chiefwithbeef44/Lobotomizer/1590DD.jpg

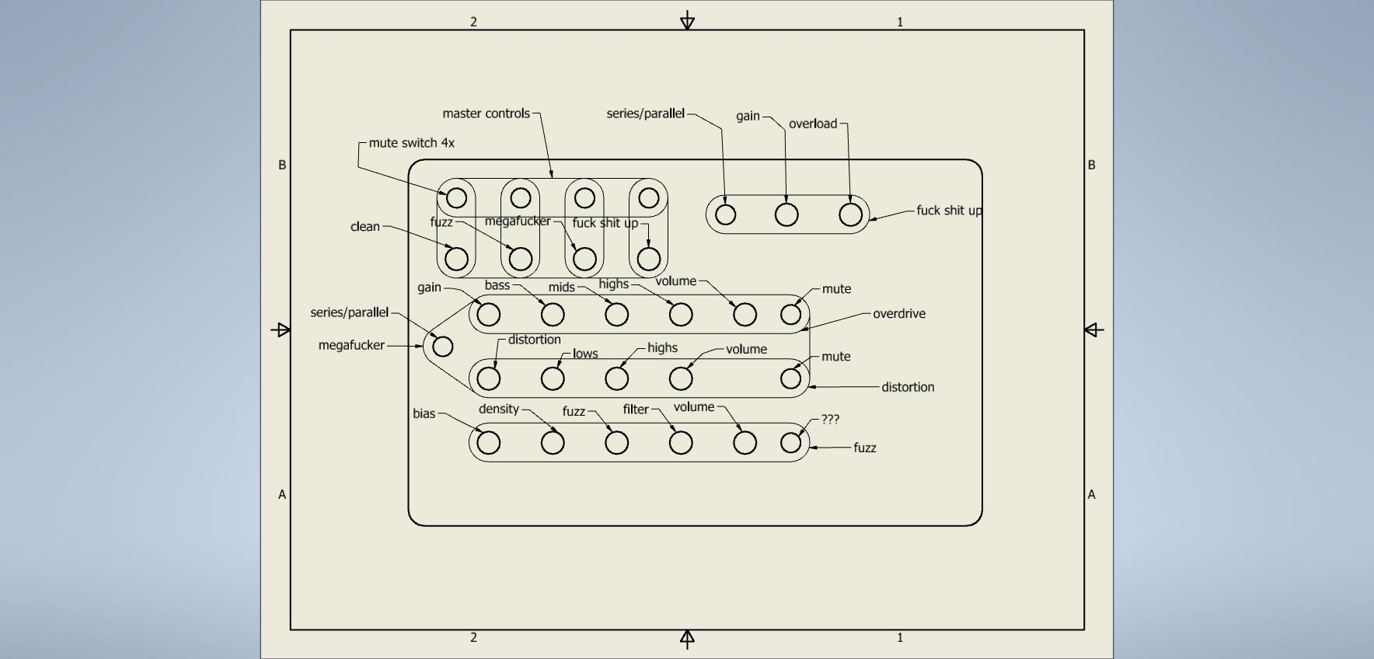
1590DD.jpg
