chiefwithbeef44/Lobotomizer/BSilk/hammer.png

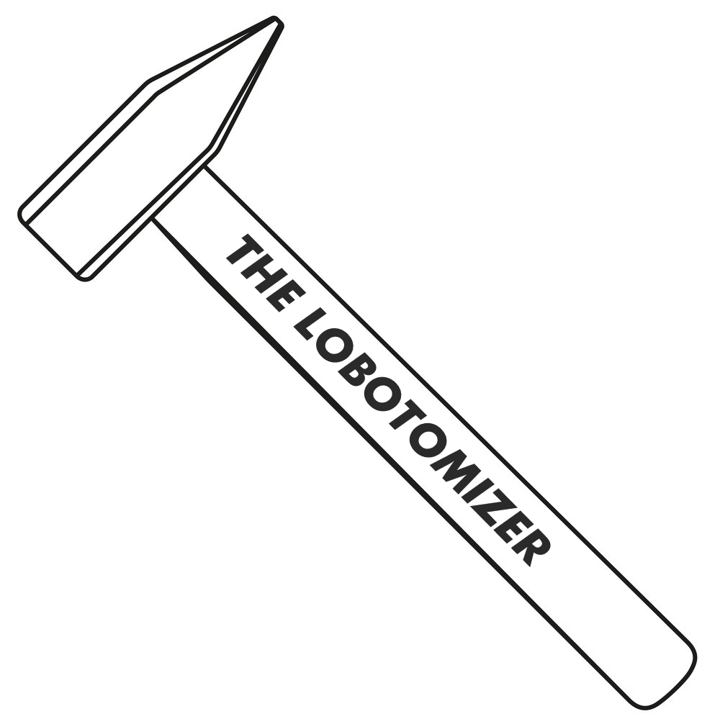
BSilk/hammer.png
