chiefwithbeef44/Lobotomizer/BSilk/lobotomizer.png

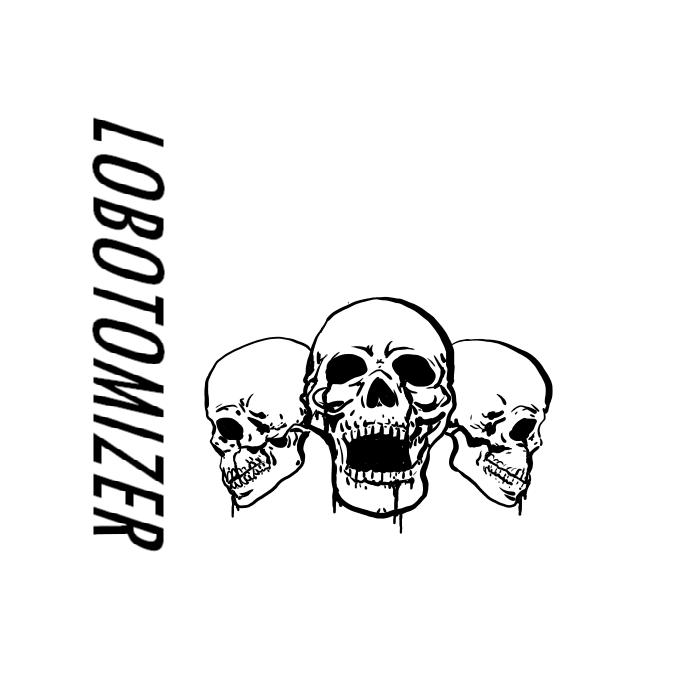
BSilk/lobotomizer.png
