chiefwithbeef44/Lobotomizer/BOM.xlsx

# | QUANTITY | PART NUMBER | MANUFACTURER PART NUMBER | DESCRIPTION | CUSTOMER REFERENCE | BACKORDER | UNIT PRICE | EXTENDED PRICE
1 | 3 | BC5223CT-ND | K101J10C0GF5UH5 | CAP CER 100PF 50V C0G/NP0 RADIAL |  | 0 | 0.19 | 0.57
2 | 11 | 399-9859-1-ND | C315C104M5U5TA7303 | CAP CER 0.1UF 50V Z5U RADIAL |  | 0 | 0.157 | 1.73
3 | 7 | 732-8851-1-ND | 860020672005 | CAP ALUM 1UF 20% 50V RADIAL |  | 0 | 0.1 | 0.70
4 | 2 | BC2677CT-ND | K223K10X7RF5UH5 | CAP CER 0.022UF 50V X7R RADIAL |  | 0 | 0.23 | 0.46
5 | 1 | BC5112-ND | D102K20Y5PH63L2R | CAP CER 1000PF 100V Y5P RADIAL |  | 0 | 0.2 | 0.20
6 | 1 | 399-13958-ND | C315C300J1G5TA | CAP CER 30PF 5% 100V C0G RADIAL |  | 0 | 0.42 | 0.42
7 | 1 | 399-9725-ND | C315C229D2G5TA | CAP CER 2.2PF 200V NP0 RADIAL |  | 0 | 0.58 | 0.58
8 | 3 | 732-8854-1-ND | 860020672008 | CAP ALUM 4.7UF 20% 50V RADIAL |  | 0 | 0.11 | 0.33
9 | 1 | BC2683CT-ND | K472K10X7RF5UH5 | CAP CER 4700PF 50V X7R RADIAL |  | 0 | 0.21 | 0.21
10 | 3 | 732-8654-1-ND | 860010672002 | CAP ALUM 0.22UF 20% 50V RADIAL |  | 0 | 0.1 | 0.30
11 | 2 | 732-8656-1-ND | 860010672004 | CAP ALUM 0.47UF 20% 50V RADIAL |  | 0 | 0.11 | 0.22
12 | 1 | BC2691CT-ND | K682K10X7RH5UH5 | CAP CER 6800PF 100V X7R RADIAL |  | 0 | 0.26 | 0.26
13 | 1 | BC2672CT-ND | K221K10X7RF5UH5 | CAP CER 220PF 50V X7R RADIAL |  | 0 | 0.19 | 0.19
14 | 6 | 1N4148VSCT-ND | 1N4148TR | DIODE GEN PURP 75V 300MA DO35 |  | 0 | 0.1 | 0.60
15 | 2 | 1N5817DICT-ND | 1N5817-T | DIODE SCHOTTKY 20V 1A DO41 |  | 0 | 0.39 | 0.78
16 | 2 | 1N4001GP-E3/54GICT-ND | 1N4001GP-E3/54 | DIODE GEN PURP 50V 1A DO204AL |  | 0 | 0.57 | 1.14
17 | 4 | 1N5227BTRFSCT-ND | 1N5227BTR | DIODE ZENER 3.6V 500MW DO35 |  | 0 | 0.16 | 0.64
18 | 2 | 1514-2N5089PBFREE-ND | 2N5089 PBFREE | TRANS NPN 25V 0.05A TO-92 |  | 0 | 0.49 | 0.98
19 | 2 | 2368-NTE467-ND | NTE467 | JFET-N-CH CHOPPER/FAST SW |  | 0 | 1.31 | 2.62
20 | 1 | 1514-2N5087PBFREE-ND | 2N5087 PBFREE | TRANS PNP 50V 0.05A TO-92 |  | 0 | 0.49 | 0.49
21 | 2 | MPSA05-APMSCT-ND | MPSA05-AP | TRANS NPN 60V 0.625A TO-92 |  | 0 | 0.34 | 0.68
22 | 3 | CF14JT470KCT-ND | CF14JT470K | RES 470K OHM 5% 1/4W AXIAL |  | 0 | 0.1 | 0.30
23 | 3 | CF14JT47K0CT-ND | CF14JT47K0 | RES 47K OHM 5% 1/4W AXIAL |  | 0 | 0.1 | 0.30
24 | 1 | CF14JT22K0CT-ND | CF14JT22K0 | RES 22K OHM 5% 1/4W AXIAL |  | 0 | 0.1 | 0.10
25 | 1 | CF14JT2K20CT-ND | CF14JT2K20 | RES 2.2K OHM 5% 1/4W AXIAL |  | 0 | 0.1 | 0.10
26 | 1 | CF14JT47R0CT-ND | CF14JT47R0 | RES 47 OHM 5% 1/4W AXIAL |  | 0 | 0.1 | 0.10
27 | 1 | CF14JT560RCT-ND | CF14JT560R | RES 560 OHM 5% 1/4W AXIAL |  | 0 | 0.1 | 0.10
28 | 1 | CF14JT1K50CT-ND | CF14JT1K50 | RES 1.5K OHM 5% 1/4W AXIAL |  | 0 | 0.1 | 0.10
29 | 1 | S470QCT-ND | CFM14JT470R | RES 470 OHM 5% 1/4W AXIAL |  | 0 | 0.1 | 0.10
30 | 10 | CF12JT100KCT-ND | CF12JT100K | RES 100K OHM 5% 1/2W AXIAL |  | 0 | 0.065 | 0.65
31 | 10 | CF12JT100KCT-ND | CF12JT100K | RES 100K OHM 5% 1/2W AXIAL |  | 0 | 0.065 | 0.65
32 | 12 | CF14JT1M00CT-ND | CF14JT1M00 | RES 1M OHM 5% 1/4W AXIAL |  | 0 | 0.036 | 0.43
33 | 12 | CF14JT10K0CT-ND | CF14JT10K0 | RES 10K OHM 5% 1/4W AXIAL |  | 0 | 0.036 | 0.43
34 | 10 | CF14JT1K00CT-ND | CF14JT1K00 | RES 1K OHM 5% 1/4W AXIAL |  | 0 | 0.036 | 0.36
35 | 2 | CF14JT39K0CT-ND | CF14JT39K0 | RES 39K OHM 5% 1/4W AXIAL |  | 0 | 0.1 | 0.20
36 | 2 | BC4514CT-ND | MBB0207VD5001BC100 | RES 5K OHM 0.1% 0.4W AXIAL |  | 0 | 0.66 | 1.32
37 | 1 | CF14JT6K80CT-ND | CF14JT6K80 | RES 6.8K OHM 5% 1/4W AXIAL |  | 0 | 0.1 | 0.10
38 | 1 | CF14JT68K0CT-ND | CF14JT68K0 | RES 68K OHM 5% 1/4W AXIAL |  | 0 | 0.1 | 0.10
39 | 1 | CF14JT910KCT-ND | CF14JT910K | RES 910K OHM 5% 1/4W AXIAL |  | 0 | 0.1 | 0.10
40 | 2 | CF14JT180KCT-ND | CF14JT180K | RES 180K OHM 5% 1/4W AXIAL |  | 0 | 0.1 | 0.20
41 | 1 | CF14JT4K70CT-ND | CF14JT4K70 | RES 4.7K OHM 5% 1/4W AXIAL |  | 0 | 0.1 | 0.10
42 | 1 | CF14JT220RCT-ND | CF14JT220R | RES 220 OHM 5% 1/4W AXIAL |  | 0 | 0.1 | 0.10
43 | 1 | 987-1305-ND | P160KN-0QC15B50K | POT 50K OHM 1/5W PLASTIC LINEAR |  | 0 | 0.85 | 0.85
44 | 3 | 987-1667-ND | P160KN-0QD15B1MEG | POT 1M OHM 1/5W PLASTIC LINEAR |  | 0 | 0.85 | 2.55
45 | 8 | 987-1300-ND | P160KN-0QC15B100K | POT 100K OHM 1/5W PLASTIC LINEAR |  | 0 | 0.85 | 6.80
46 | 5 | 2368-54-302PC-ND | 54-302PC | SW-TOGGLE SPDT 5A |  | 0 | 1.42 | 7.10
47 | 1 | 2368-54-303E-ND | 54-303E | SWITCH/TOGGLE/SPDT/5A |  | 0 | 1.97 | 1.97
48 | 1 | 2368-54-307PC-ND | 54-307PC | SW TOGGLE DPDT 5A |  | 0 | 1.66 | 1.66
49 | 1 | 296-7414-5-ND | TLC27M4AIN | IC OPAMP GP 4 CIRCUIT 14DIP |  | 0 | 1.72 | 1.72
50 | 1 | 497-2947-5-ND | L7805ABV | IC REG LINEAR 5V 1.5A TO220AB |  | 0 | 0.7 | 0.70
51 | 1 | 296-43959-5-ND | LM386N-3/NOPB | IC AMP CLASS AB MONO 700MW 8DIP |  | 0 | 1.5 | 1.50
52 | 1 | 296-14997-5-ND | TL072IP | IC OPAMP JFET 2 CIRCUIT 8DIP |  | 0 | 0.95 | 0.95
53 | 1 | LM741CNNS/NOPB-ND | LM741CN/NOPB | IC OPAMP GP 1 CIRCUIT 8DIP |  | 0 | 0.91 | 0.91
54 | 2 | 3185-FCR50055-ND | FCR50055 | S1 OFFSET MONO CHASSIS GROUND |  | 0 | 1.21 | 2.42
55 | 1 | 2368-57-PJ30-ND | 57-PJ30 | POWER JACK-DC PANEL MOUNT |  | 0 | 1.47 | 1.47
56 | 1 | 2260-WBNCC633731-2OZ-ND | WBNCC633731-2OZ | NO-CLEAN FLUX CORE SOLDER, 63/37 |  | 0 | 5.75 | 5.75
