chiefwithbeef44/Lobotomizer/1590DD.stp

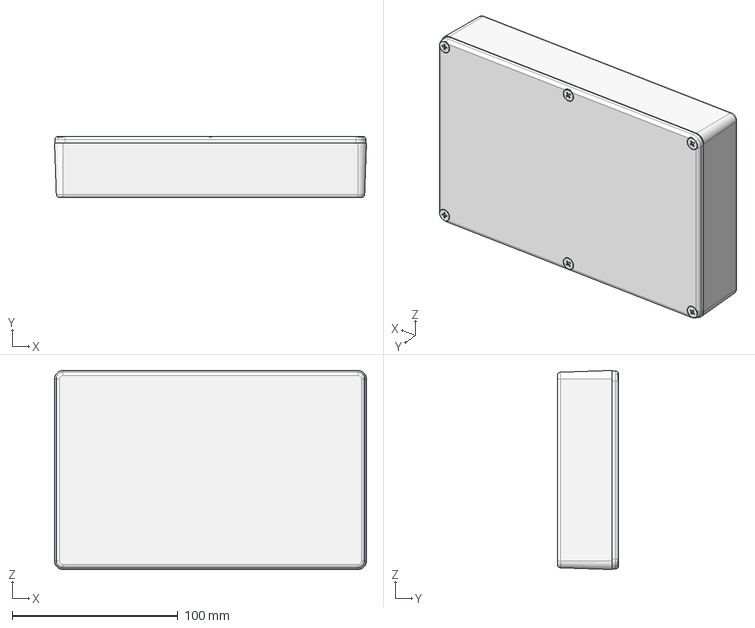
[picture p4: CAD file, 2022-02-07]
1590DD.stp
188.0 x 37.0 x 120.0 mm
