chiefwithbeef44/Lobotomizer/1590DD BOX.stp

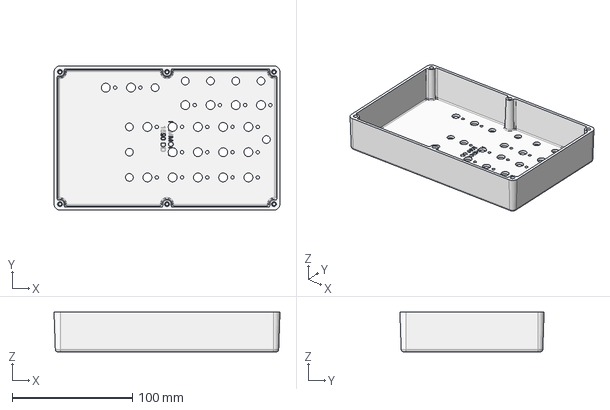
[picture p5: CAD file, 2022-02-07]
1590DD BOX.stp
188.0 x 120.0 x 33.0 mm
