chiefwithbeef44/Lobotomizer/(list of files, cad)

Other CAD files:
1590D-DD-E LID.ipt
1590DD BOX.ipt
1590DD.dwg
1590DD.iam
OldVersions/1590DD BOX.0002.ipt
