chiefwithbeef44/Lobotomizer/Lobotomizer.kicad_pcb

## KiCad design Lobotomizer.kicad_pcb (2022-02-18)

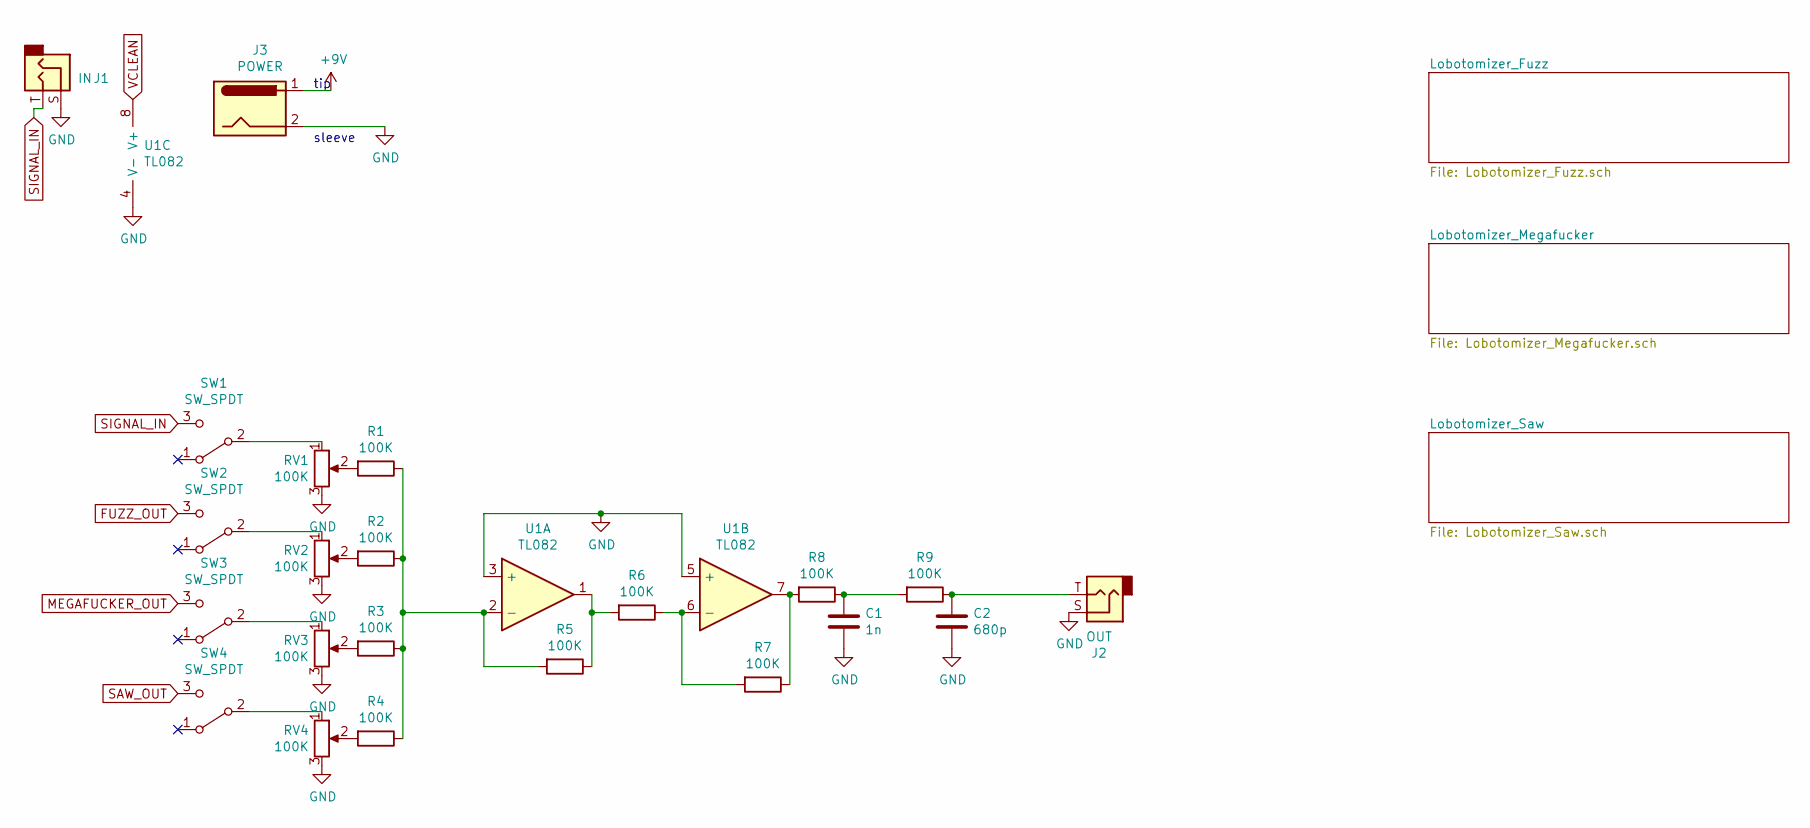
[picture p10: schematic Lobotomizer.sch]

Parts:
C1: 1n; C_Disc_D3.8mm_W2.6mm_P2.50mm
C2: 680p; C_Disc_D4.3mm_W1.9mm_P5.00mm
J1: IN; Jack_6.35mm_Neutrik_NMJ4HFD2_Horizontal
J2: OUT; Jack_6.35mm_Neutrik_NMJ4HFD2_Horizontal
J3: POWER; BarrelJack_CUI_PJ-063AH_Horizontal
R1, R2, R3, R4, R5, R6, R7, R8, R9: 100K; R_Axial_DIN0204_L3.6mm_D1.6mm_P5.08mm_Horizontal
RV1, RV2, RV3, RV4: 100K; Potentiometer_Bourns_3266Y_Vertical
SW1, SW2, SW3, SW4: SW_SPDT; TerminalBlock_Phoenix_MKDS-1,5-3-5.08_1x03_P5.08mm_Horizont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
U1: TL082; DIP-8_W7.62mm

Connections:
FUZZ_OUT: SW2.3 (C); also elsewhere on the board
GND: C1.2, C2.2, J1.S, J2.S, J3.2, RV1.3, RV2.3, RV3.3, RV4.3, U1.3 (+), U1.4 (V-), U1.5 (+); also elsewhere on the board
MEGAFUCKER_OUT: SW3.3 (C); also elsewhere on the board
unnamed: C1.1, R8.1, R9.2
unnamed: C2.1, J2.T, R9.1
unnamed: R1.1, R2.1, R3.1, R4.1, R5.2, U1.2 (-)
unnamed: R1.2, RV1.2
unnamed: R2.2, RV2.2
unnamed: R3.2, RV3.2
unnamed: R4.2, RV4.2
unnamed: R5.1, R6.2, U1.1
unnamed: R6.1, R7.2, U1.6 (-)
unnamed: R7.1, R8.2, U1.7
unnamed: RV1.1, SW1.2 (B)
unnamed: RV2.1, SW2.2 (B)
unnamed: RV3.1, SW3.2 (B)
unnamed: RV4.1, SW4.2 (B)
SAW_OUT: SW4.3 (C); also elsewhere on the board
SIGNAL_IN: J1.T, SW1.3 (C); also elsewhere on the board
VCLEAN: J3.1, U1.8 (V+); also elsewhere on the board

Notes on the sheet:
sleeve
tip

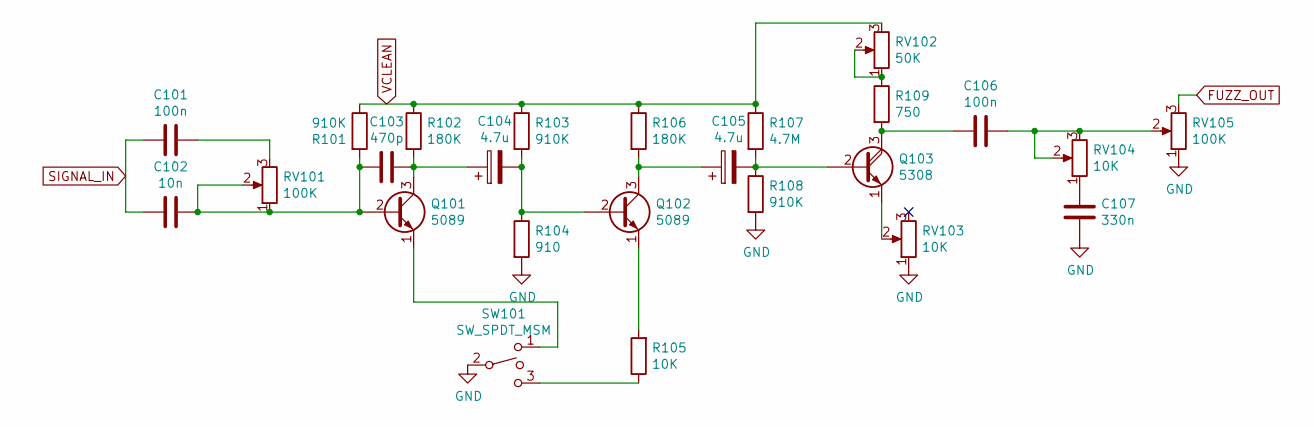
[picture p11: schematic Lobotomizer_Fuzz.sch]

Parts:
C101, C106: 100n; C_Disc_D3.8mm_W2.6mm_P2.50mm
C102: 10n; C_Disc_D4.3mm_W1.9mm_P5.00mm
C103: 470p; C_Disc_D4.3mm_W1.9mm_P5.00mm
C104, C105: 4.7u; CP_Radial_D5.0mm_P2.00mm
C107: 330n; CP_Radial_D5.0mm_P2.00mm
Q101, Q102: 5089; TO-92_Inline
Q103: 5308; TO-92_Inline
R101, R103, R108: 910K; R_Axial_DIN0207_L6.3mm_D2.5mm_P7.62mm_Horizontal
R102, R106: 180K; R_Axial_DIN0207_L6.3mm_D2.5mm_P7.62mm_Horizontal
R104: 910; R_Axial_DIN0207_L6.3mm_D2.5mm_P7.62mm_Horizontal
R105: 10K; R_Axial_DIN0207_L6.3mm_D2.5mm_P7.62mm_Horizontal
R107: 4.7M; R_Axial_DIN0207_L6.3mm_D2.5mm_P10.16mm_Horizontal
R109: 750; R_Axial_DIN0204_L3.6mm_D1.6mm_P5.08mm_Horizontal
RV101, RV105: 100K; Potentiometer_Bourns_3266Y_Vertical
RV102: 50K; Potentiometer_Bourns_3266Y_Vertical
RV103, RV104: 10K; Potentiometer_Bourns_3266Y_Vertical
SW101: SW_SPDT_MSM; TerminalBlock_Phoenix_MKDS-1,5-3-5.08_1x03_P5.08mm_Horizont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

Connections:
FUZZ_OUT: RV105.3; also elsewhere on the board
GND: C107.2, R104.2, R108.2, RV103.1, RV105.1, SW101.2; also elsewhere on the board
unnamed: C101.1, RV101.3
unnamed: C102.1, C103.2, Q101.2 (B), R101.2, RV101.1, RV101.2
unnamed: C103.1, C104.1, Q101.3 (C), R102.2
unnamed: C104.2, Q102.2 (B), R103.2, R104.1
unnamed: C105.1, Q102.3 (C), R106.2
unnamed: C105.2, Q103.2 (B), R107.2, R108.1
unnamed: C106.1, RV104.2, RV104.3, RV105.2
unnamed: C106.2, Q103.3 (C), R109.2
unnamed: C107.1, RV104.1
unnamed: Q101.1 (E), SW101.1
unnamed: Q102.1 (E), R105.2
unnamed: Q103.1 (E), RV103.2
unnamed: R105.1, SW101.3
unnamed: R109.1, RV102.1, RV102.2
SIGNAL_IN: C101.2, C102.2; also elsewhere on the board
VCLEAN: R101.1, R102.1, R103.1, R106.1, R107.1, RV102.3; also elsewhere on the board

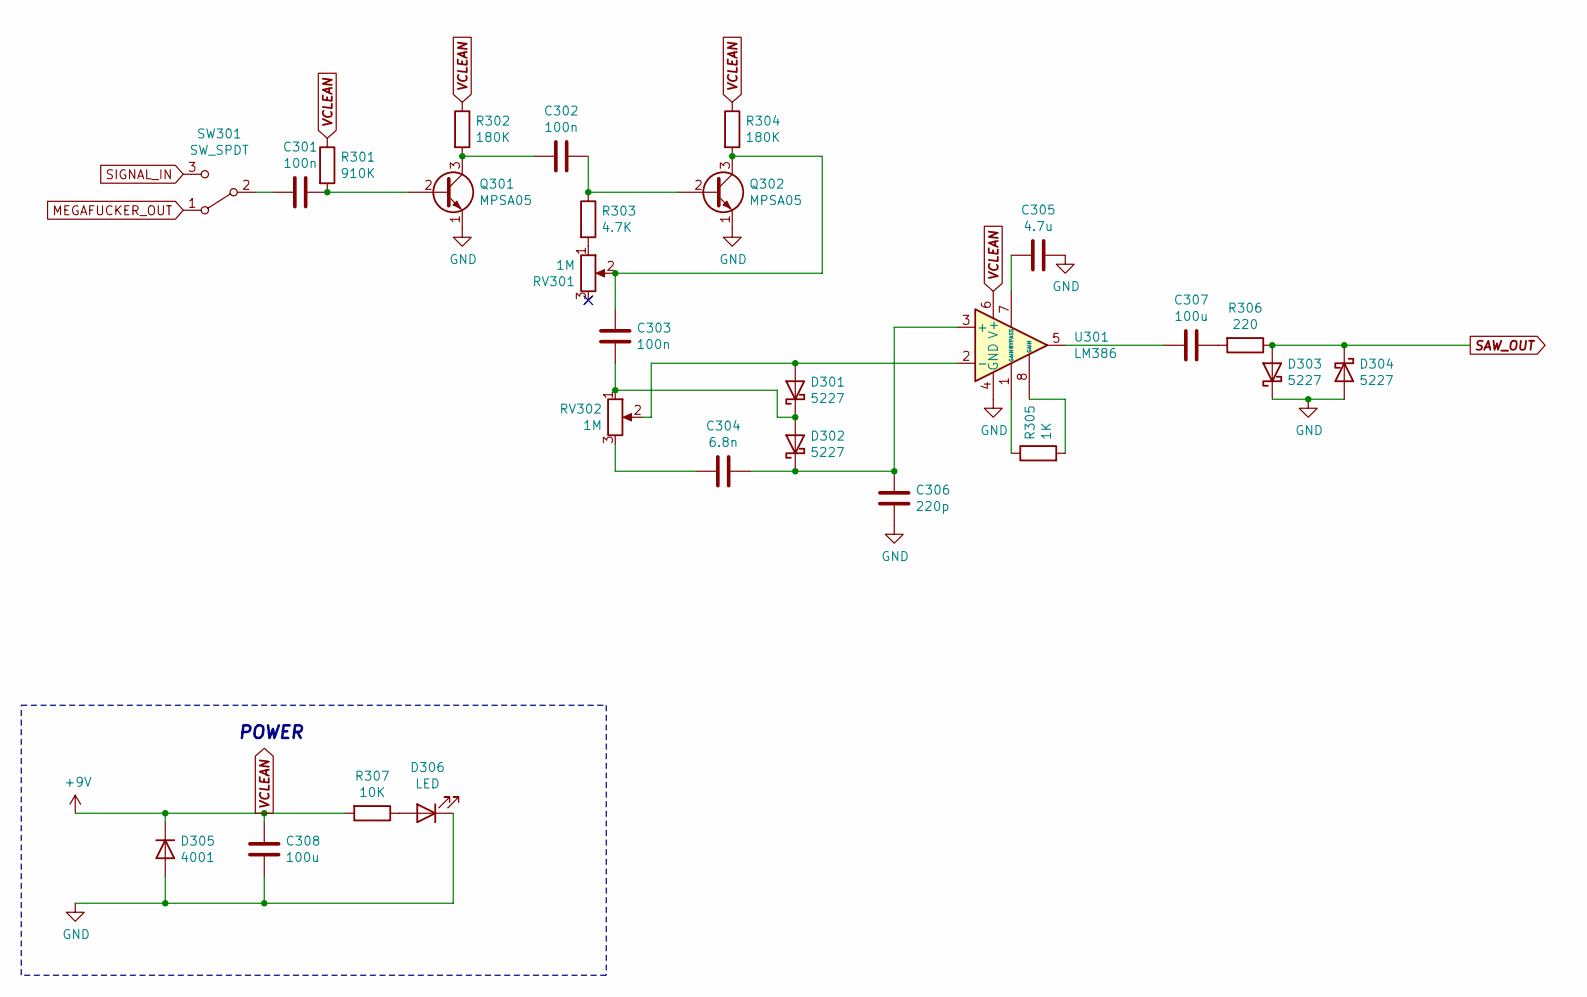
[picture p12: schematic Lobotomizer_Saw.sch]

Parts:
C301, C302, C303: 100n; C_Disc_D3.8mm_W2.6mm_P2.50mm
C304: 6.8n; C_Disc_D4.7mm_W2.5mm_P5.00mm
C305: 4.7u; CP_Radial_D5.0mm_P2.00mm
C306: 220p; C_Disc_D4.7mm_W2.5mm_P5.00mm
C307, C308: 100u; CP_Radial_D5.0mm_P2.00mm
D301, D302, D303, D304: 5227; D_DO-35_SOD27_P7.62mm_Horizontal
D305: 4001; D_DO-41_SOD81_P7.62mm_Horizontal
D306: LED; LED_D5.0mm
Q301, Q302: MPSA05; TO-92_Inline
R301: 910K; R_Axial_DIN0207_L6.3mm_D2.5mm_P7.62mm_Horizontal
R302, R304: 180K; R_Axial_DIN0207_L6.3mm_D2.5mm_P7.62mm_Horizontal
R303: 4.7K; R_Axial_DIN0207_L6.3mm_D2.5mm_P7.62mm_Horizontal
R305: 1K; R_Axial_DIN0204_L3.6mm_D1.6mm_P5.08mm_Horizontal
R306: 220; R_Axial_DIN0204_L3.6mm_D1.6mm_P5.08mm_Horizontal
R307: 10K; R_Axial_DIN0207_L6.3mm_D2.5mm_P7.62mm_Horizontal
RV301, RV302: 1M; Potentiometer_Bourns_3266Y_Vertical
SW301: SW_SPDT; TerminalBlock_Phoenix_MKDS-1,5-3-5.08_1x03_P5.08mm_Horizont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
U301: LM386; DIP-8_W7.62mm

Connections:
GND: C305.1, C306.2, C308.2, D303.1 (K), D304.2 (A), D305.2 (A), D306.1 (K), Q301.1 (E), Q302.1 (E), U301.4 (GND); also elsewhere on the board
MEGAFUCKER_OUT: SW301.1 (A); also elsewhere on the board
unnamed: C301.1, Q301.2 (B), R301.2
unnamed: C301.2, SW301.2 (B)
unnamed: C302.1, Q302.2 (B), R303.1
unnamed: C302.2, Q301.3 (C), R302.2
unnamed: C303.1, Q302.3 (C), R304.2, RV301.2
unnamed: C303.2, D301.1 (K), D302.2 (A), RV302.1
unnamed: C304.1, C306.1, D302.1 (K), U301.3 (+)
unnamed: C304.2, RV302.3
unnamed: C305.2, U301.7 (BYPASS)
unnamed: C307.1, R306.2
unnamed: C307.2, U301.5
unnamed: D301.2 (A), RV302.2, U301.2 (-)
unnamed: D306.2 (A), R307.1
unnamed: R303.2, RV301.1
unnamed: R305.1, U301.1 (GAIN)
unnamed: R305.2, U301.8 (GAIN)
SAW_OUT: D303.2 (A), D304.1 (K), R306.1; also elsewhere on the board
SIGNAL_IN: SW301.3 (C); also elsewhere on the board
VCLEAN: C308.1, D305.1 (K), R301.1, R302.1, R304.1, R307.2, U301.6 (V+); also elsewhere on the board

Notes on the sheet:
POWER

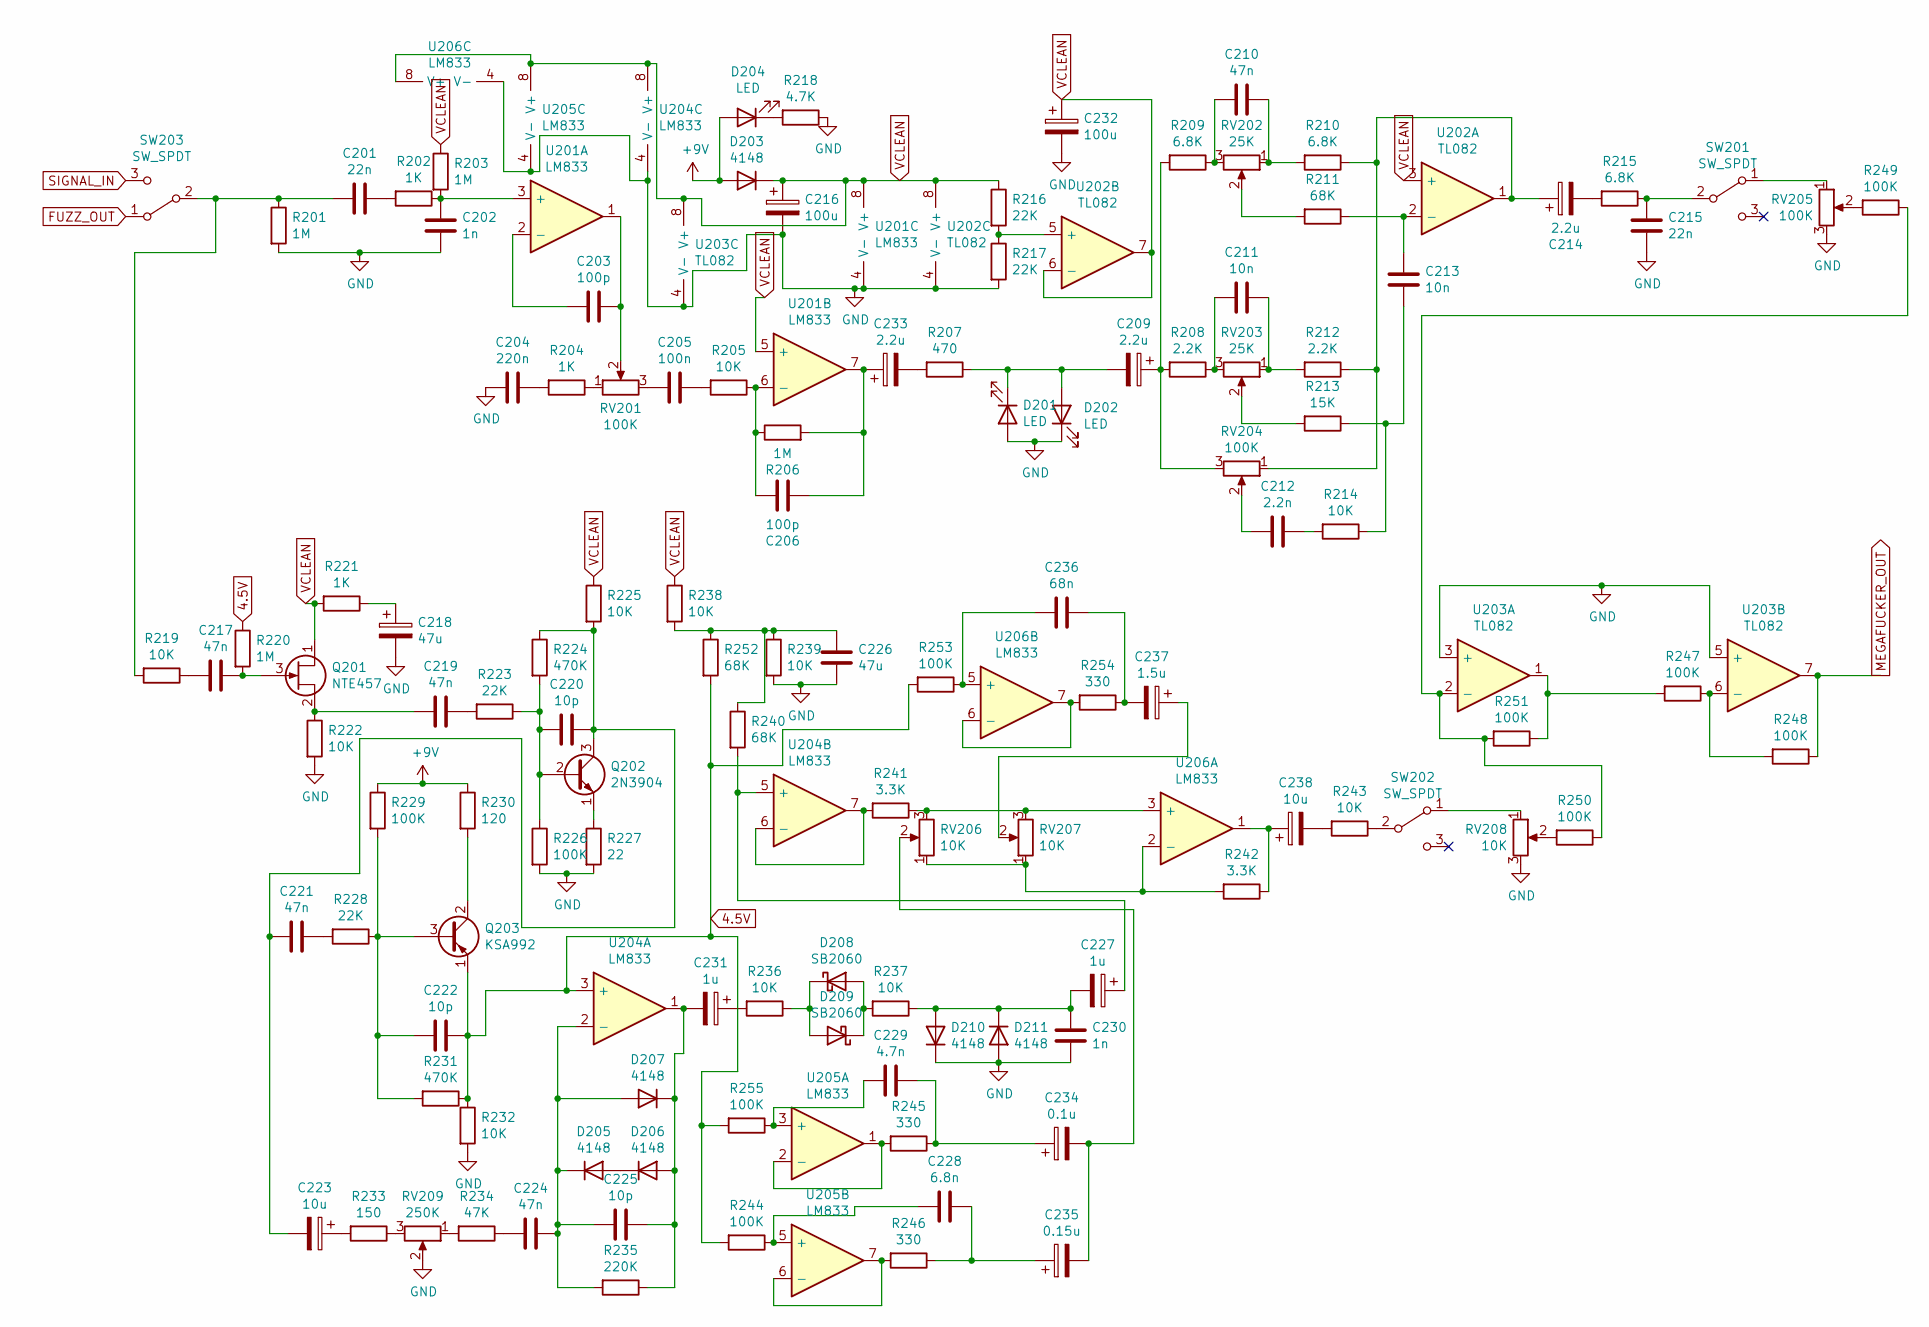
[picture p13: schematic Lobotomizer_Megafucker.sch]

Parts:
C201, C215: 22n; C_Disc_D4.3mm_W1.9mm_P5.00mm
C202, C230: 1n; C_Disc_D3.8mm_W2.6mm_P2.50mm
C203, C206: 100p; C_Disc_D3.8mm_W2.6mm_P2.50mm
C204: 220n; CP_Radial_D5.0mm_P2.00mm
C205: 100n; C_Disc_D3.8mm_W2.6mm_P2.50mm
C209, C214, C233: 2.2u; CP_Radial_D5.0mm_P2.00mm
C210, C217, C219, C221, C224: 47n; C_Disc_D4.3mm_W1.9mm_P5.00mm
C211, C213: 10n; C_Disc_D4.3mm_W1.9mm_P5.00mm
C212: 2.2n; C_Disc_D4.3mm_W1.9mm_P5.00mm
C216, C232: 100u; CP_Radial_D5.0mm_P2.00mm
C218, C226: 47u; CP_Radial_D5.0mm_P2.00mm
C220, C222, C225: 10p; C_Disc_D7.0mm_W2.5mm_P5.00mm
C223, C238: 10u; CP_Radial_D5.0mm_P2.00mm
C227, C231: 1u; CP_Radial_D5.0mm_P2.00mm
C228: 6.8n; C_Disc_D4.7mm_W2.5mm_P5.00mm
C229: 4.7n; C_Disc_D7.0mm_W2.5mm_P5.00mm
C234: 0.1u; CP_Radial_D5.0mm_P2.00mm
C235: 0.15u; CP_Radial_D5.0mm_P2.50mm
C236: 68n; C_Disc_D7.0mm_W2.5mm_P5.00mm
C237: 1.5u; CP_Radial_D5.0mm_P2.50mm
D201, D202, D204: LED; LED_D5.0mm
D203, D205, D206, D207, D210, D211: 4148; D_DO-35_SOD27_P7.62mm_Horizontal
D208, D209: SB2060; D_DO-201AD_P12.70mm_Horizontal
Q201: NTE457; TO-92_Inline
Q202: 2N3904; TO-92_Inline
Q203: KSA992; TO-92_Inline
R201, R203, R206, R220: 1M; R_Axial_DIN0204_L3.6mm_D1.6mm_P5.08mm_Horizontal
R202, R204, R221: 1K; R_Axial_DIN0204_L3.6mm_D1.6mm_P5.08mm_Horizontal
R205, R214, R219, R222, R225, R232, R236, R237, R238, R239, R243: 10K; R_Axial_DIN0207_L6.3mm_D2.5mm_P7.62mm_Horizontal
R207: 470; R_Axial_DIN0204_L3.6mm_D1.6mm_P5.08mm_Horizontal
R208, R212: 2.2K; R_Axial_DIN0207_L6.3mm_D2.5mm_P7.62mm_Horizontal
R209, R210, R215: 6.8K; R_Axial_DIN0207_L6.3mm_D2.5mm_P7.62mm_Horizontal
R211, R240, R252: 68K; R_Axial_DIN0207_L6.3mm_D2.5mm_P7.62mm_Horizontal
R213: 15K; R_Axial_DIN0207_L6.3mm_D2.5mm_P7.62mm_Horizontal
R216, R217, R223, R228: 22K; R_Axial_DIN0207_L6.3mm_D2.5mm_P7.62mm_Horizontal
R218: 4.7K; R_Axial_DIN0207_L6.3mm_D2.5mm_P7.62mm_Horizontal
R224, R231: 470K; R_Axial_DIN0204_L3.6mm_D1.6mm_P5.08mm_Horizontal
R226, R229, R244, R247, R248, R249, R250, R251, R253, R255: 100K; R_Axial_DIN0204_L3.6mm_D1.6mm_P5.08mm_Horizontal
R227: 22; R_Axial_DIN0207_L6.3mm_D2.5mm_P7.62mm_Horizontal
R230: 120; R_Axial_DIN0207_L6.3mm_D2.5mm_P7.62mm_Horizontal
R233: 150; R_Axial_DIN0207_L6.3mm_D2.5mm_P7.62mm_Horizontal
R234: 47K; R_Axial_DIN0207_L6.3mm_D2.5mm_P7.62mm_Horizontal
R235: 220K; R_Axial_DIN0207_L6.3mm_D2.5mm_P7.62mm_Horizontal
R241, R242: 3.3K; R_Axial_DIN0204_L3.6mm_D1.6mm_P5.08mm_Horizontal
R245, R246, R254: 330; R_Axial_DIN0207_L6.3mm_D2.5mm_P7.62mm_Horizontal
RV201, RV204, RV205: 100K; Potentiometer_Bourns_3266Y_Vertical
RV202, RV203: 25K; Potentiometer_Bourns_3266Y_Vertical
RV206, RV207, RV208: 10K; Potentiometer_Bourns_3266Y_Vertical
RV209: 250K; Potentiometer_Bourns_3266Y_Vertical
SW201, SW202, SW203: SW_SPDT; TerminalBlock_Phoenix_MKDS-1,5-3-5.08_1x03_P5.08mm_Horizont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
U201, U204, U205, U206: LM833; DIP-8_W7.62mm
U202, U203: TL082; DIP-8_W7.62mm

Connections:
4.5V: C222.1, Q203.1 (E), R220.1, R231.1, R232.1, R244.2, R252.2, R253.2, R255.2, U204.3 (+)
FUZZ_OUT: SW203.1 (A); also elsewhere on the board
GND: C202.2, C204.1, C215.2, C216.2, C218.2, C226.2, C230.2, C232.2, D201.2 (A), D202.1 (K), D210.1 (K), D211.2 (A), R201.2, R217.2, R218.1, R222.2, R226.2, R227.2, R232.2, R239.2, RV205.3, RV208.3, RV209.2, U201.4 (V-), U202.4 (V-), U203.3 (+), U203.4 (V-), U203.5 (+), U204.4 (V-), U205.4 (V-), U206.4 (V-); also elsewhere on the board
MEGAFUCKER_OUT: R248.1, U203.7; also elsewhere on the board
unnamed: C201.1, R202.2
unnamed: C201.2, R201.1, R219.2, SW203.2 (B)
unnamed: C202.1, R202.1, R203.2, U201.3 (+)
unnamed: C203.1, RV201.2, U201.1
unnamed: C203.2, U201.2 (-)
unnamed: C204.2, R204.2
unnamed: C205.1, R205.2
unnamed: C205.2, RV201.3
unnamed: C206.1, R205.1, R206.1, U201.6 (-)
unnamed: C206.2, C233.1, R206.2, U201.7
unnamed: C209.1, R208.2, R209.2, RV204.3
unnamed: C209.2, D201.1 (K), D202.2 (A), R207.1
unnamed: C210.1, R210.2, RV202.1
unnamed: C210.2, R209.1, RV202.3
unnamed: C211.1, R212.2, RV203.1
unnamed: C211.2, R208.1, RV203.3
unnamed: C212.1, R214.2
unnamed: C212.2, RV204.2
unnamed: C213.1, R211.1, U202.2 (-)
unnamed: C213.2, R213.1, R214.1
unnamed: C214.1, R210.1, R212.1, RV204.1, U202.1
unnamed: C214.2, R215.2
unnamed: C215.1, R215.1, SW201.2 (B)
unnamed: C217.1, Q201.3 (G), R220.2
unnamed: C217.2, R219.1
unnamed: C218.1, R221.1
unnamed: C219.1, R223.2
unnamed: C219.2, Q201.2 (S), R222.1
unnamed: C220.1, C221.2, C223.2, Q202.3 (C), R224.1, R225.2
unnamed: C220.2, Q202.2 (B), R223.1, R224.2, R226.1
unnamed: C221.1, R228.2
unnamed: C222.2, Q203.3 (B), R228.1, R229.2, R231.2
unnamed: C223.1, R233.2
unnamed: C224.1, C225.2, D205.1 (K), D207.2 (A), R235.2, U204.2 (-)
unnamed: C224.2, R234.1
unnamed: C225.1, C231.2, D206.2 (A), D207.1 (K), R235.1, U204.1
unnamed: C226.1, R238.2, R239.1, R240.1, R252.1
unnamed: C227.1, R240.2, U204.5 (+)
unnamed: C227.2, C230.1, D210.2 (A), D211.1 (K), R237.1
unnamed: C228.1, C235.1, R246.1
unnamed: C228.2, R244.1, U205.5 (+)
unnamed: C229.1, C234.1, R245.1
unnamed: C229.2, R255.1, U205.3 (+)
unnamed: C231.1, R236.2
unnamed: C233.2, R207.2
unnamed: C234.2, C235.2, RV206.2
unnamed: C236.1, C237.2, R254.1
unnamed: C236.2, R253.1, U206.5 (+)
unnamed: C237.1, RV207.2
unnamed: C238.1, R242.1, U206.1
unnamed: C238.2, R243.2
unnamed: D204.1 (K), R218.2
unnamed: D205.2 (A), D206.1 (K)
unnamed: D208.1 (K), D209.2 (A), R236.1
unnamed: D208.2 (A), D209.1 (K), R237.2
unnamed: Q202.1 (E), R227.1
unnamed: Q203.2 (C), R230.2
unnamed: R204.1, RV201.1
unnamed: R211.2, RV202.2
unnamed: R213.2, RV203.2
unnamed: R216.2, R217.1, U202.5 (+)
unnamed: R233.1, RV209.3
unnamed: R234.2, RV209.1
unnamed: R241.1, RV206.3, RV207.3, U206.3 (+)
unnamed: R241.2, U204.6 (-), U204.7
unnamed: R242.2, RV206.1, RV207.1, U206.2 (-)
unnamed: R243.1, SW202.2 (B)
unnamed: R245.2, U205.1, U205.2 (-)
unnamed: R246.2, U205.6 (-), U205.7
unnamed: R247.1, R248.2, U203.6 (-)
unnamed: R247.2, R251.1, U203.1
unnamed: R249.1, R250.1, R251.2, U203.2 (-)
unnamed: R249.2, RV205.2
unnamed: R250.2, RV208.2
unnamed: R254.2, U206.6 (-), U206.7
unnamed: RV205.1, SW201.1 (A)
unnamed: RV208.1, SW202.1 (A)
SIGNAL_IN: SW203.3 (C); also elsewhere on the board
VCLEAN: C216.1, C232.1, D203.1 (K), D203.2 (A), D204.2 (A), Q201.1 (D), R203.1, R216.1, R221.2, R225.1, R229.1, R230.1, R238.1, U201.5 (+), U201.8 (V+), U202.3 (+), U202.6 (-), U202.7, U202.8 (V+), U203.8 (V+), U204.8 (V+), U205.8 (V+), U206.8 (V+); also elsewhere on the board

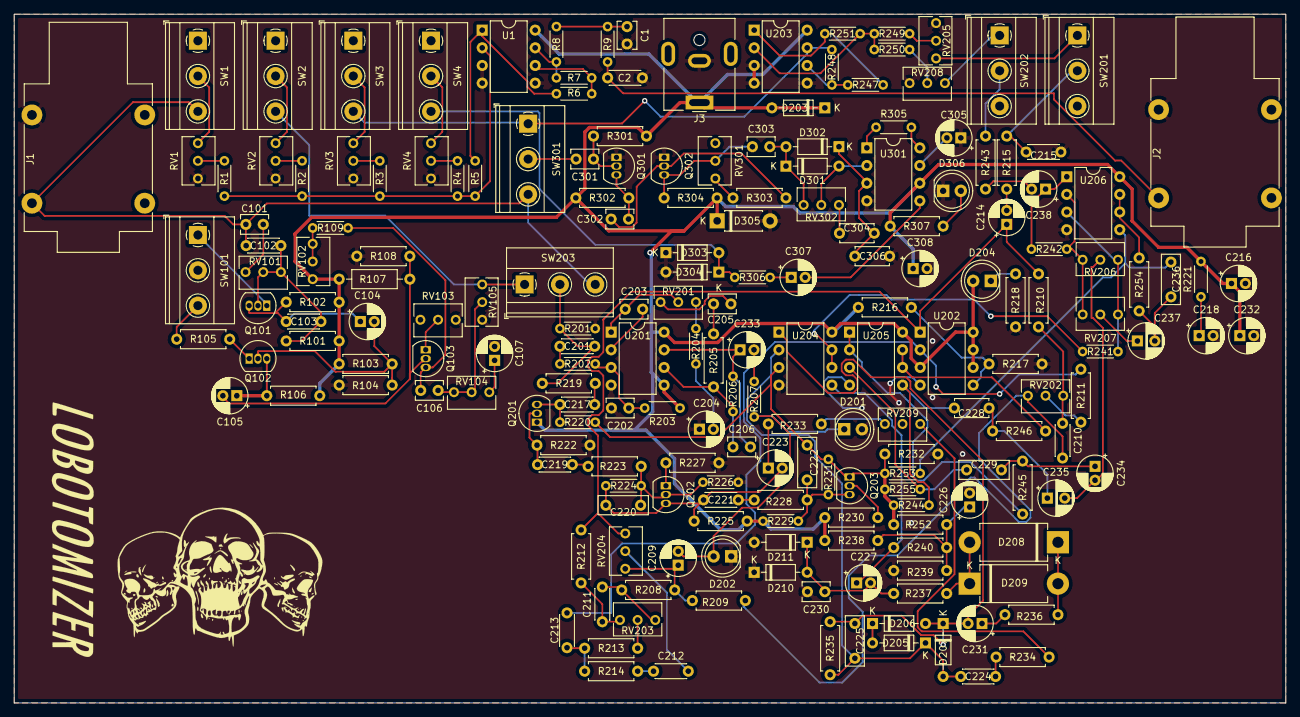
[picture p14: board Lobotomizer.kicad_pcb from above]

Board: 2 copper layers, 182.9 x 99.1 mm, 198 parts (0 on the bottom side), 128 nets.
