chiefwithbeef44/Lobotomizer/Lobotomizer-LPF/Lobotomizer-LPF.kicad_pcb

## KiCad design Lobotomizer-LPF/Lobotomizer-LPF.kicad_pcb (2022-02-07)

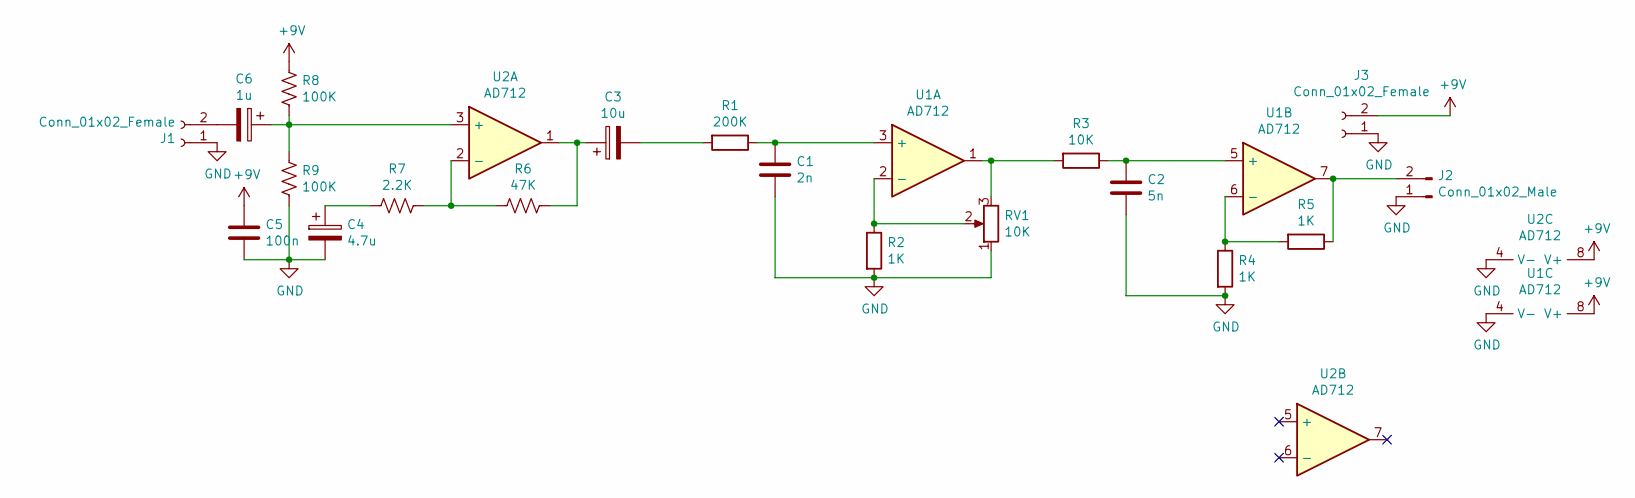
[picture p15: schematic Lobotomizer-LPF.sch]

Parts:
C1: 2n; C_Disc_D4.7mm_W2.5mm_P5.00mm
C2: 5n; C_Disc_D4.7mm_W2.5mm_P5.00mm
C3: 10u; CP_Radial_D5.0mm_P2.50mm
C4: 4.7u; CP_Radial_D5.0mm_P2.50mm
C5: 100n; C_Disc_D5.0mm_W2.5mm_P5.00mm
C6: 1u; CP_Radial_D5.0mm_P2.50mm
J1, J3: Conn_01x02_Female; PinHeader_1x02_P2.54mm_Vertical
J2: Conn_01x02_Male; PinHeader_1x02_P2.54mm_Vertical
R1: 200K; R_Axial_DIN0207_L6.3mm_D2.5mm_P10.16mm_Horizontal
R2, R4, R5: 1K; R_Axial_DIN0207_L6.3mm_D2.5mm_P7.62mm_Horizontal
R3: 10K; R_Axial_DIN0207_L6.3mm_D2.5mm_P7.62mm_Horizontal
R6: 47K; R_Axial_DIN0614_L14.3mm_D5.7mm_P25.40mm_Horizontal
R7: 2.2K; R_Axial_DIN0207_L6.3mm_D2.5mm_P7.62mm_Horizontal
R8, R9: 100K; R_Axial_DIN0207_L6.3mm_D2.5mm_P10.16mm_Horizontal
RV1: 10K; Potentiometer_Bourns_3266Y_Vertical
U1, U2: AD712; DIP-8_W7.62mm_LongPads

Connections:
+9V: C5.1, J3.2, R8.1, U1.8 (V+), U2.8 (V+)
GND: C1.2, C2.2, C4.2, C5.2, J1.1, J2.1, J3.1, R2.2, R4.2, R9.2, RV1.1, U1.4 (V-), U2.4 (V-)
unnamed: C1.1, R1.1, U1.3 (+)
unnamed: C2.1, R3.1, U1.5 (+)
unnamed: C3.1, R6.1, U2.1
unnamed: C3.2, R1.2
unnamed: C4.1, R7.2
unnamed: C6.1, R8.2, R9.1, U2.3 (+)
unnamed: C6.2, J1.2
unnamed: J2.2, R5.1, U1.7
unnamed: R2.1, RV1.2, U1.2 (-)
unnamed: R3.2, RV1.3, U1.1
unnamed: R4.1, R5.2, U1.6 (-)
unnamed: R6.2, R7.1, U2.2 (-)

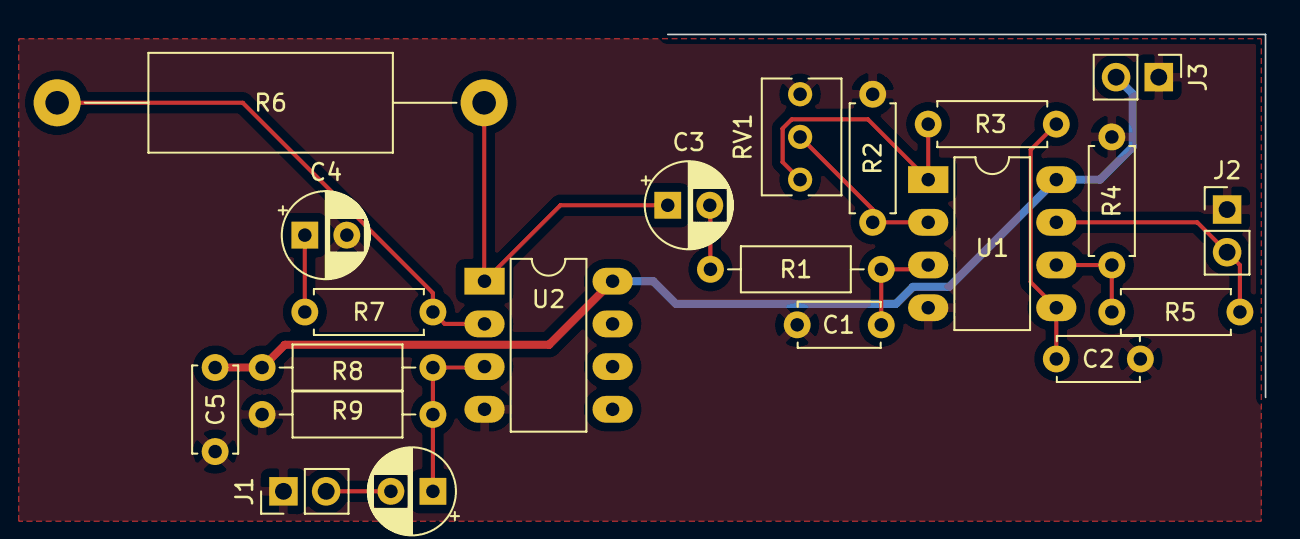
[picture p16: board Lobotomizer-LPF.kicad_pcb from above]

Board: 2 copper layers, 21 parts (0 on the bottom side), 14 nets.
