chiefwithbeef44/Lobotomizer/(commit log)

2022-01-02 finished pcb layout
    [Lobotomizer-B_Cu.gbr, Lobotomizer-B_Mask.gbr, Lobotomizer-B_Paste.gbr, Lobotomizer-B_SilkS.gbr, Lobotomizer-Edge_Cuts.gbr, Lobotomizer-F_Cu.gbr, Lobotomizer-F_Mask.gbr, Lobotomizer-F_Paste.gbr]
2022-01-03 finalized v1 design
    [Lobotomizer-B_Cu.gbr, Lobotomizer-B_Mask.gbr, Lobotomizer-B_Paste.gbr, Lobotomizer-B_SilkS.gbr, Lobotomizer-Edge_Cuts.gbr, Lobotomizer-F_Cu.gbr, Lobotomizer-F_Mask.gbr, Lobotomizer-F_Paste.gbr]
2022-01-03 add bom
    [BOM.xlsx, Lobotomizer.csv, Lobotomizer.xlsx]
2022-01-04 fixed major error
    U207:7 now connected to VCLEAN.
    [Lobotomizer-B_Cu.gbr, Lobotomizer-B_Mask.gbr, Lobotomizer-B_Paste.gbr, Lobotomizer-B_SilkS.gbr, Lobotomizer-Edge_Cuts.gbr, Lobotomizer-F_Cu.gbr, Lobotomizer-F_Mask.gbr, Lobotomizer-F_Paste.gbr]
2022-01-04 changed to pos tip, gnd sleeve jack.
    [Lobotomizer.kicad_pcb, Lobotomizer.sch]
2022-01-04 updated gbrs
    [Lobotomizer-B_Cu.gbr, Lobotomizer-B_Mask.gbr, Lobotomizer-B_Paste.gbr, Lobotomizer-B_SilkS.gbr, Lobotomizer-Edge_Cuts.gbr, Lobotomizer-F_Cu.gbr, Lobotomizer-F_Mask.gbr, Lobotomizer-F_Paste.gbr]
2022-02-07 lobotomizer v2 update
    so much changed i cant note it all here
    [1590D-DD-E LID.ipt, 1590DD BOX.0002.ipt, 1590DD BOX.ipt, 1590DD BOX.stp, 1590DD.dwg, 1590DD.iam, 1590DD.stp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]
2022-02-07 updated gerbers
    [Lobotomizer-B_Cu.gbr, Lobotomizer-B_Mask.gbr, Lobotomizer-B_Paste.gbr, Lobotomizer-B_SilkS.gbr, Lobotomizer-Edge_Cuts.gbr, Lobotomizer-F_Cu.gbr, Lobotomizer-F_Mask.gbr, Lobotomizer-F_Paste.gbr]
2022-02-18 v2 board gerbers
    [Lobotomizer-B_Cu.gbr, Lobotomizer-B_Mask.gbr, Lobotomizer-B_Paste.gbr, Lobotomizer-B_SilkS.gbr, Lobotomizer-Edge_Cuts.gbr, Lobotomizer-F_Cu.gbr, Lobotomizer-F_Mask.gbr, Lobotomizer-F_Paste.gbr]
